ps915/Chorus-RF-Laptimer-PCB/README.md

# Chorus-RF-Laptimer-PCB
4in1 PCB for the Chorus RF Laptimer by Andrey Voroshkov
https://github.com/voroshkov/Chorus-RF-Laptimer

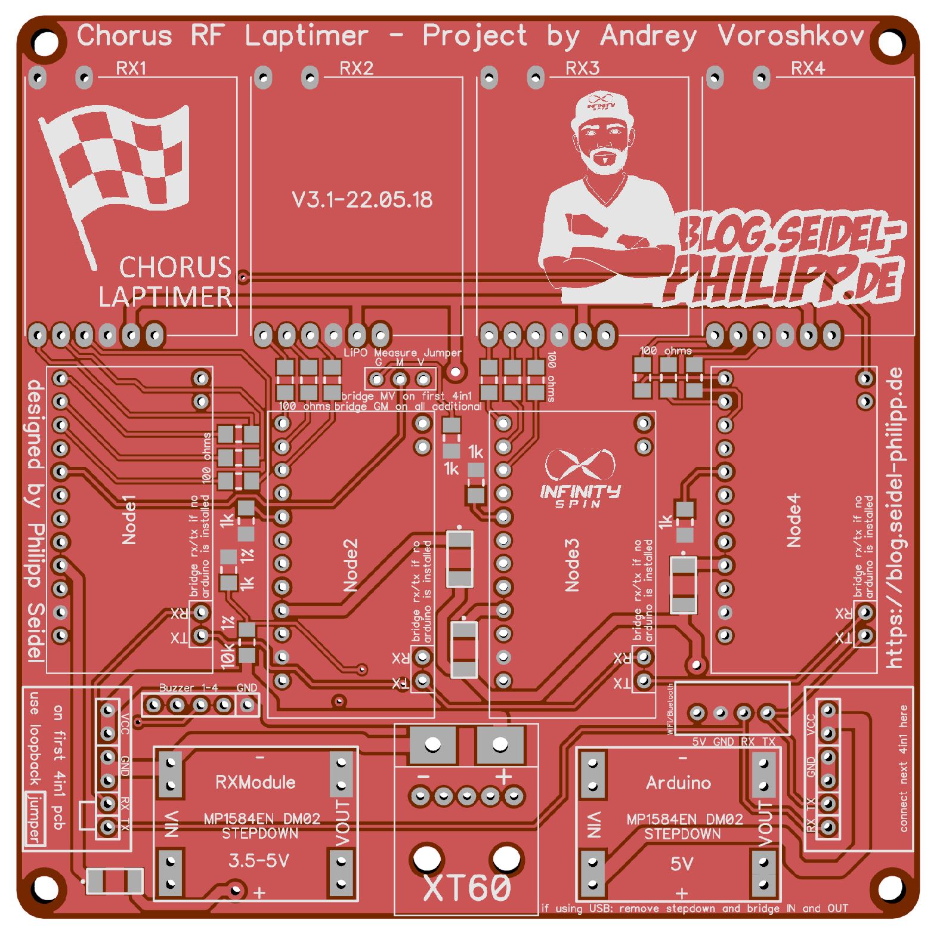
[picture p1: p3.JPG]
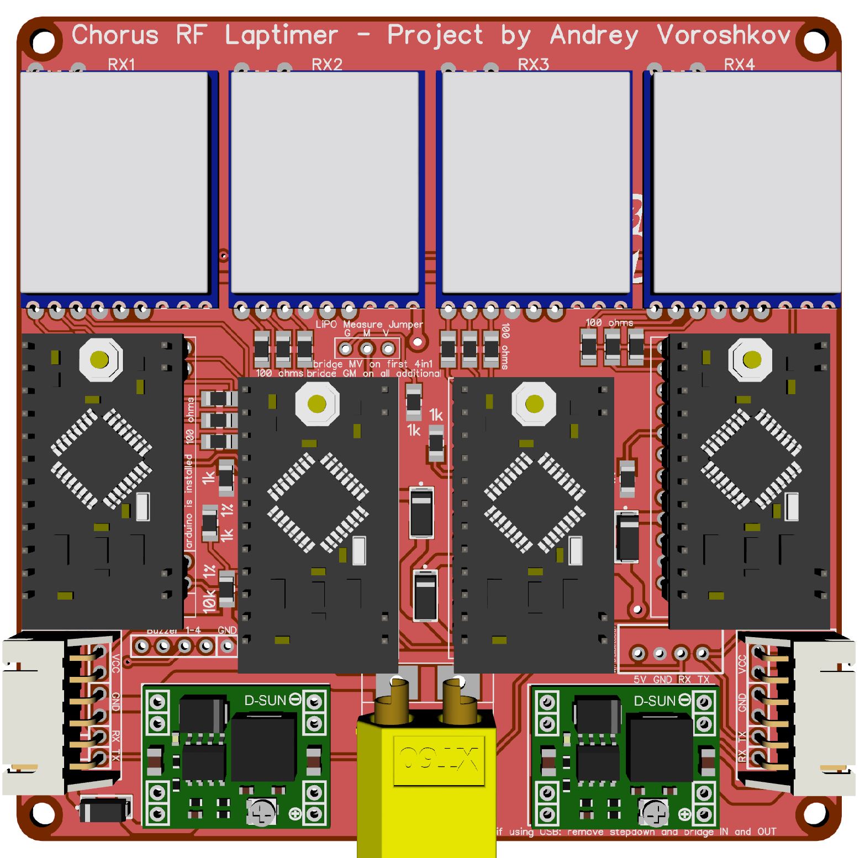
[picture p2: p1.JPG]
 

IMAGE ALT TEXT HERE (https://www.youtube.com/watch?v=avLRJ5z0UP4)

https://www.youtube.com/watch?v=avLRJ5z0UP4

# Features
* PCB for 4 Nodes (4 Pilots)
* easy extendable via JST XH cable (8 Pilots)
* 5V stepdown for Arduinos
* adjustable stepdown for RX Modules (use 3.5V to keep temperature low)
* 92 x 92mm mounting holes
* XT60 PowerIn
* 5V USB PowerIn (if you want to use a powerbank)
* stacked hardware - can be changed in seconds
* Buzzer Port to connect one Buzzer per Node

# Changelog
### [ALL RELEASES](https://github.com/ps915/Chorus-RF-Laptimer-PCB/releases) 
### 22.05.2018 - v3.1 beta released [DOWNLOAD](https://github.com/ps915/Chorus-RF-Laptimer-PCB/files/2025616/chorus_4in1_3.1_gerber_file.zip)
* inital release
* i did not tested this PCB. To V3.0 i just added the Diodes and did cleaned it up a bit. V3.0 worked so far. Please report any issues!

# Important
#### Less than 4 nodes?
You can use less than 4 nodes. All you have to do, is to bridge TX/RX (see silkscreen) of the unused nodes. Always use at least "Node1" because the voltage measurement is connected to this node.
#### 5 V power via USB
If you want to power the unit via 5 V USB, please remove stepdown marked as "Arduino" and bridge IN and OUT of it to pass the power from the USB to the Arduios.
#### How to track 8 pilots and more
If you plan to track more than 4 pilots at the same time, connect just connect two or more PCBs together.
* Please always set the Loopback Jumper to the first PCB.
* Connect the next PCB via 6Pin JST cable
* On the first PCB, bridge MV
* On following PCBs please bridge GM
* WiFi/Bluetooth Module always connects to the last PCB. 
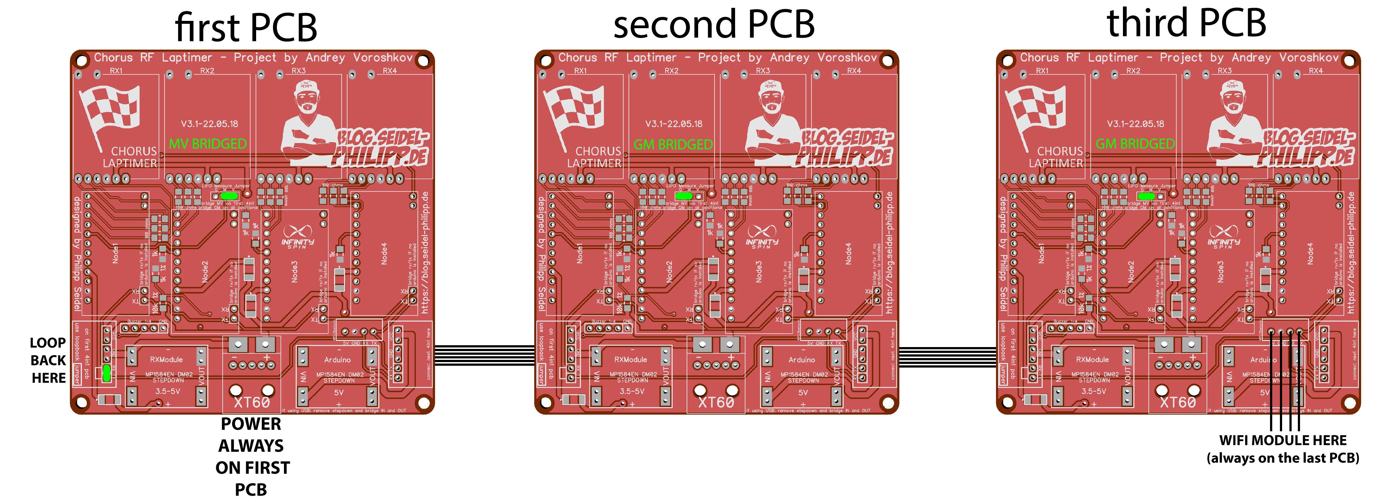
[picture p3: p5.jpg]


# What do you need (4 nodes)
* 1x 4in1 PCB
* 4x [Arduino Pro Mini](https://www.banggood.com/Wholesale-New-Ver-Pro-Mini-ATMEGA328-328p-5V-16MHz-Arduino-Compatible-Nano-Size-p-68534.html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)
* 4x [RX5808 (with SPI mod)](https://www.banggood.com/FPV-5_8G-Wireless-Audio-Video-Receiving-Module-RX5808-p-84775.html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)
* 12x 100 ohm 1206 SMD Resistor
* 4x 1k ohm 1206 SMD Resistor
* 1x 10k 1% ohm 1206 SMD Resistor
* 1x 1k 1% ohm 1206 SMD Resistor
* 4x [1n5817 smd 1A 20V do-214ac Schottky diode](https://de.aliexpress.com/item/Free-shipping-100pcs-sma-1n5817-smd-1A-20V-do-214ac-Schottky-diode-SOt-23-diode-ss12/32337976826.html)
* 2x [6 Pin JST XH 90° Connector](https://de.aliexpress.com/item/100Pcs-2-54Mm-Spacing-series-Right-Angle-Bend-the-foot-Jst-Xh-Connector-Pin-Header-White/32819782475.html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)
* 1x [USB Breakout Board](https://de.aliexpress.com/item/10PCS-CJMCU-Breakout-Power-Supply-Module-Micro-USB-Interface-Power-Adapter-Board-USB-5V-Breakout-Module/32789480622.html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)
* 2x [Pin Jumper](https://www.banggood.com/100pcs-2_54mm-Jumper-Cap-Short-Circuit-Cap-Pin-Connection-Block-p-1212414.html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)
* 1x [DT-06 WiFi Module](https://www.banggood.com/Geekcreit-DT-06-Wireless-WiFi-Serial-Port-Transparent-Transmission-Module-TTL-To-WiFi-p-1141047.html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)
* 1x [5V Stepdown](https://www.banggood.com/5pcs-DC-DC-5V-3A-Power-Supply-Module-Buck-Step-Down-Regulator-Module-24V-12V-9V-To-5V-Fixed-Output-p-1198421.html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)
* 1x [adjustable stepdown](https://www.banggood.com/5Pcs-Mini-DC-DC-Converter-Adjustable-Power-Supply-Step-Down-Module-p-951165.html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)
* optional [6Pin JST XH cable](https://de.aliexpress.com/item/20-Pcs-10cm-6Pin-JST-XH-Connector-Cable-Wire-2-54mm-Pitch-Female-to-Female/32767693655.html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) for connecting two or more PCBs together
* [1x XT60](https://www.banggood.com/Amass-XT60-MaleFemale-Bullet-Connector-Plugs-For-RC-Lipo-Battery-p-929670.html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)
* 4x 3Pin Pin Header Socket
* 4x 6Pin Pin Header Socket
* 4x 12Pin Pin Header Socket
* 16x 2Pin Pin Header Socket
* manny Pin Header RM 2.54

(some links are affiliate links)

# Software
https://github.com/voroshkov/Chorus-RF-Laptimer

# Blog post about the project
* english https://blog.seidel-philipp.de/chorus-rf-laptimer-4in1-pcb-english/
* deutsch https://blog.seidel-philipp.de/chorus-rf-laptimer-4in1-pcb/

# Ordering the PCB
you can order the PCB from china:
1. Go to FUSION PCB [www.seeedstudio.com](https://www.seeedstudio.com/fusion_pcb.html#utm_source=seidel-philipp.de&utm_medium=banner)
2. Upload gerber file (chorus_4in1_3.1_gerber_file.zip)
3. verify order settings
* Base Material: FR-4
* No. of Layers: 2
* PCB Dimensions: 100mm x 100mm
* PCB Quantity: 10 (you will get 10 identical PCBs - thats the minimum quantity)
* No. of Different Designs: 1
* PCB Thickness: 1.6mm
* PCB Color: Red
* Surface Finish: HASL
* Minimum Solder Mask Dam: 0.4mm
* Copper Weight: 1oz
* Minimum Drill Hole Size: 0.3mm
* Trace Width / Spacing: 6/6 mil
* Blind or Buried Vias: No
* Plated Half-holes / Castellated Holes: No
* Impedance Control: No
3. add to cart
4. pay the order! Done!
5. share unused PCBs with the community! =)
