ps915/Chorus-RF-Laptimer-PCB/chorus_4in1_v3.1_schematics.jpg

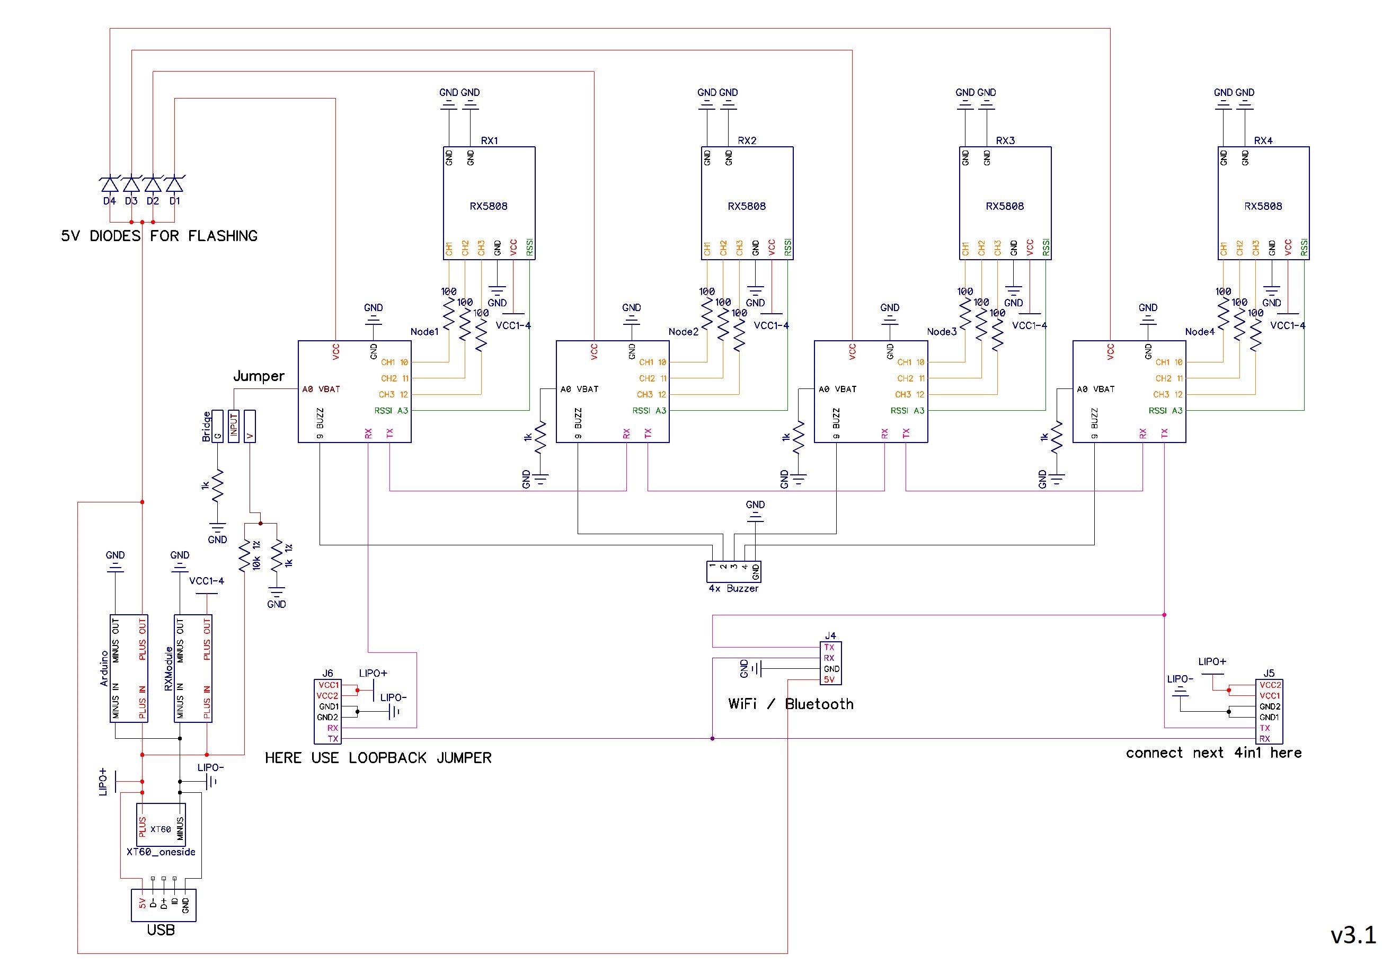
chorus_4in1_v3.1_schematics.jpg
