ps915/Chorus-RF-Laptimer-PCB/p2.JPG

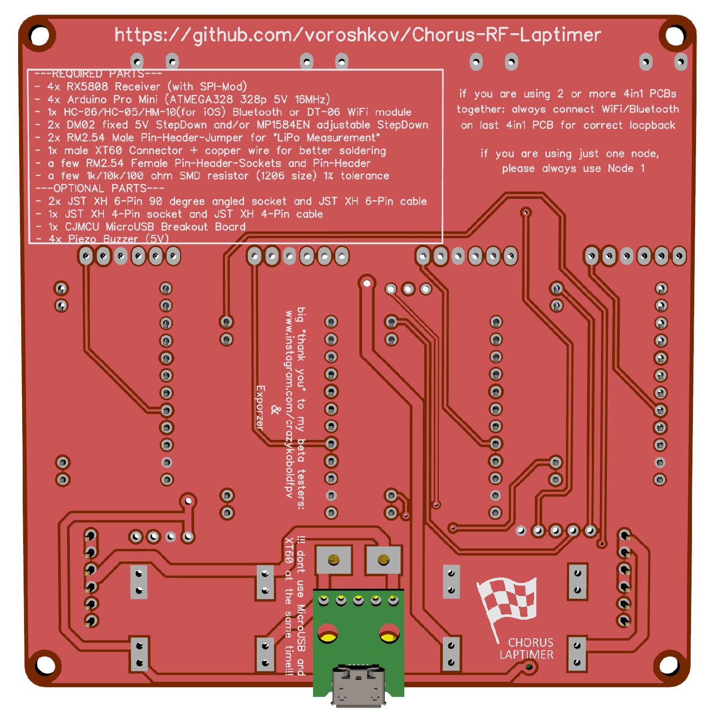
p2.JPG
