ps915/Chorus-RF-Laptimer-PCB/p4.JPG

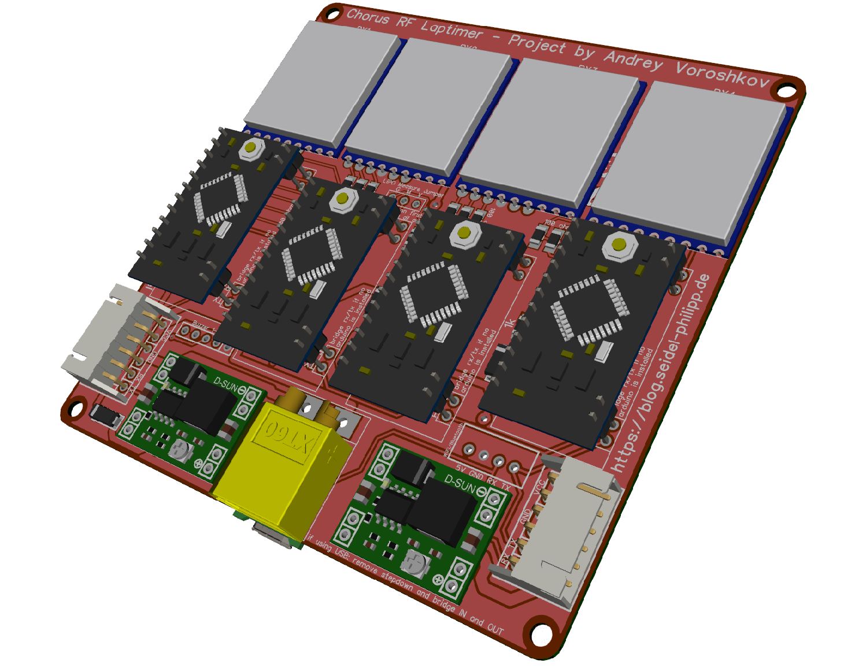
p4.JPG
