ps915/Chorus-RF-Laptimer-PCB/(list of files, drawings)

Other design files:
ChorusRF_laptimer_v3_4in1.dch
ChorusRF_laptimer_v3_4in1.dip
