ps915/Chorus-RF-Laptimer-PCB/(threads)

Thread 2 (2020-08-02):

V3.1: VBAT monitoring sends VBAT to analog input pin when voltage regulators aren't installed

SpencerGraffunder, 2020-08-02:
The voltage divider for VBAT sensing uses the 5V output ground, which is not connected to the VBAT ground, so if the two grounds are not connected together through the voltage regulators, the voltage divider doesn't work. A solution would be to simply connect the grounds with a trace, bodge wire, or ensure a voltage regulator is installed at all times.
